AmorZhao/EEproject/IR sensor circuit.asc

10k: res; additional R
C1: cap; 100nF
C2: cap; 100nF
C3: cap; 27nF
C4: cap; 30nF
C5: cap; 1nF
coil: ind; 117µF
D1: diode
LT1366: opamp
LT1366: opamp
R1: res; IR diode
R2: res; 1k
R3: res; 10k
R4: res; 3k
R5: res; 2k
R6: res; 10k
R7: res; 10k
R8: res; 1Mega
R9: res; 1k
R10: res
R11: res; 510
R12: res; 10k
R13: res; 10k
R14: res; 10k
U1: opamp
Named nets: 5V, 0, Vout, switchPin, Vin
